bartoszp1992/airMouse/housing/RC1_main.FCStd

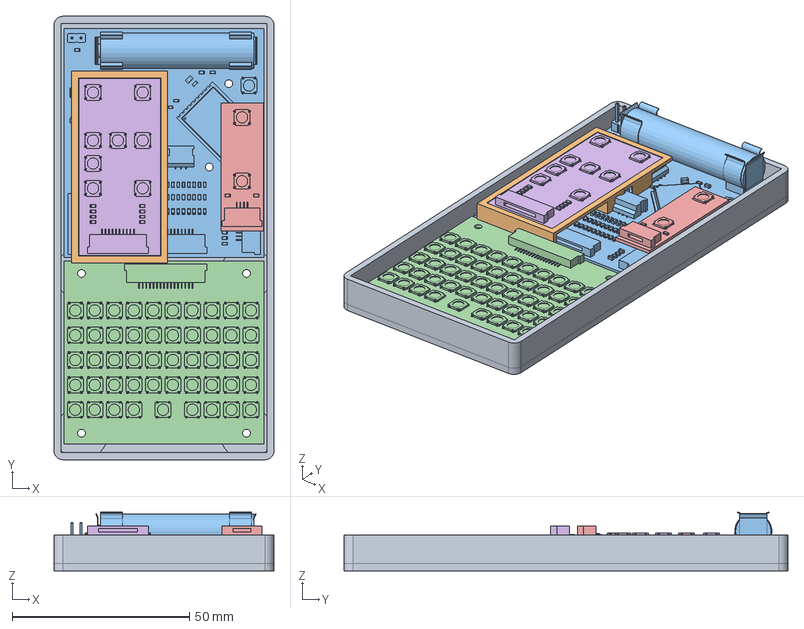
[picture p2: CAD file, 2025-02-20]
housing/RC1_main.FCStd
62.0 x 125.0 x 16.5 mm
housing
mouse distance
airMouse-mcu
airMouse-keyboard
airMouse-thumb
airMouse-mouse
