bartoszp1992/airMouse/housing/mini2/output/mini2-main.stl

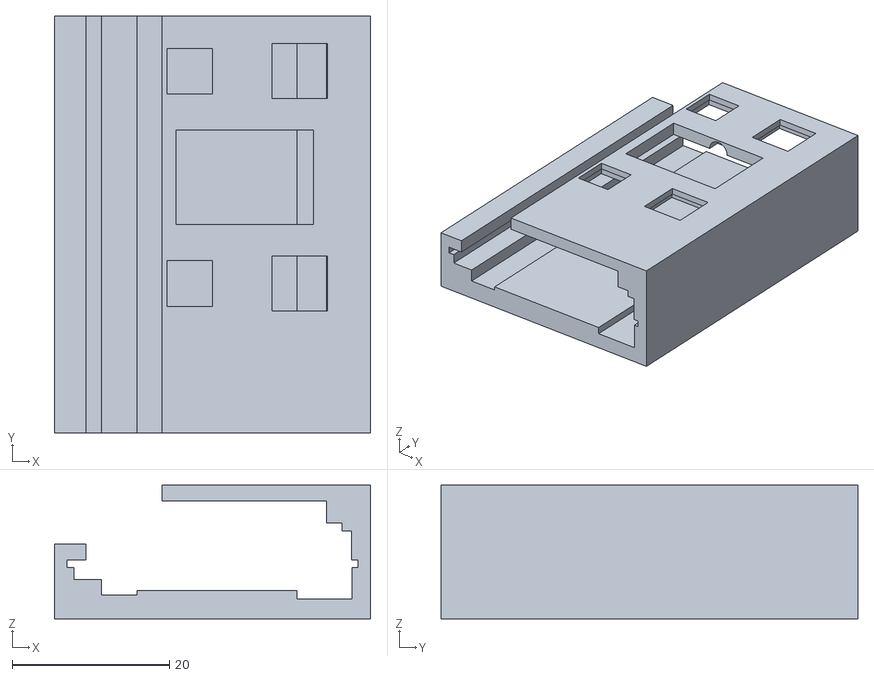
[picture p3: CAD file, 2025-04-11]
housing/mini2/output/mini2-main.stl
40.2 x 53.0 x 17.0
