bartoszp1992/airMouse/housing/RC1/output/proto/RC1_main-bottom cover.stl

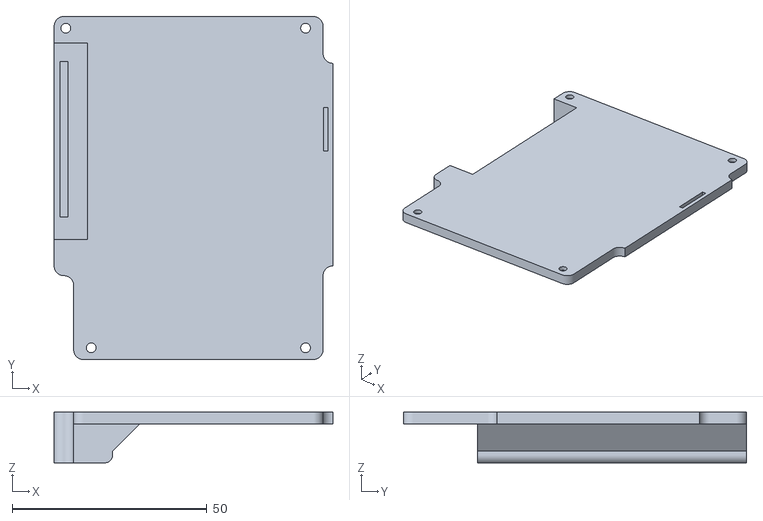
[picture p4: CAD file, 2025-03-11]
housing/RC1/output/proto/RC1_main-bottom cover.stl
71.5 x 88.0 x 13.0
