bartoszp1992/airMouse/housing/RC1/output/proto/RC1_main-top base.stl

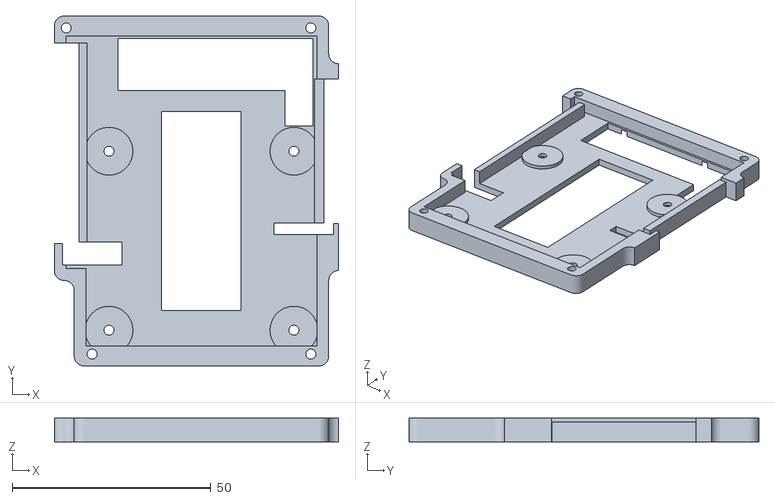
[picture p5: CAD file, 2025-03-11]
housing/RC1/output/proto/RC1_main-top base.stl
71.5 x 88.0 x 6.00
