bartoszp1992/airMouse/housing/RC1/output/proto/RC1_main-top cover.stl

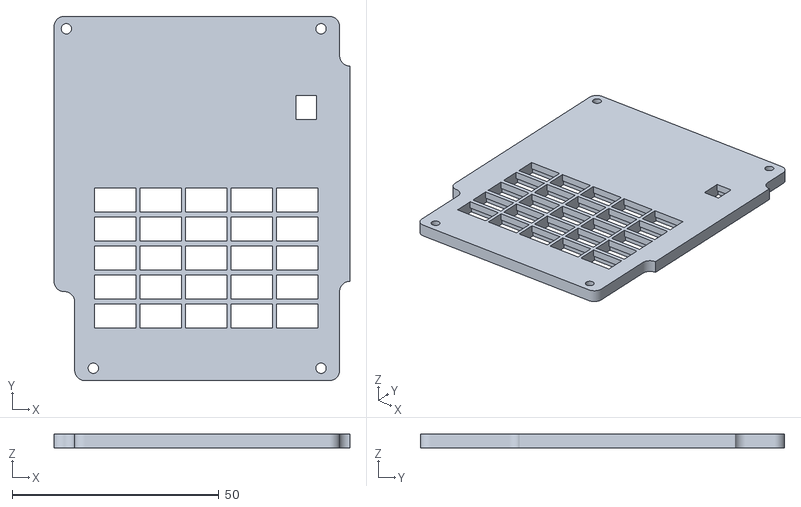
[picture p6: CAD file, 2025-03-11]
housing/RC1/output/proto/RC1_main-top cover.stl
71.5 x 88.0 x 3.50
