bartoszp1992/airMouse/housing/RC1/output/proto/RC1_main-integrating pin.stl

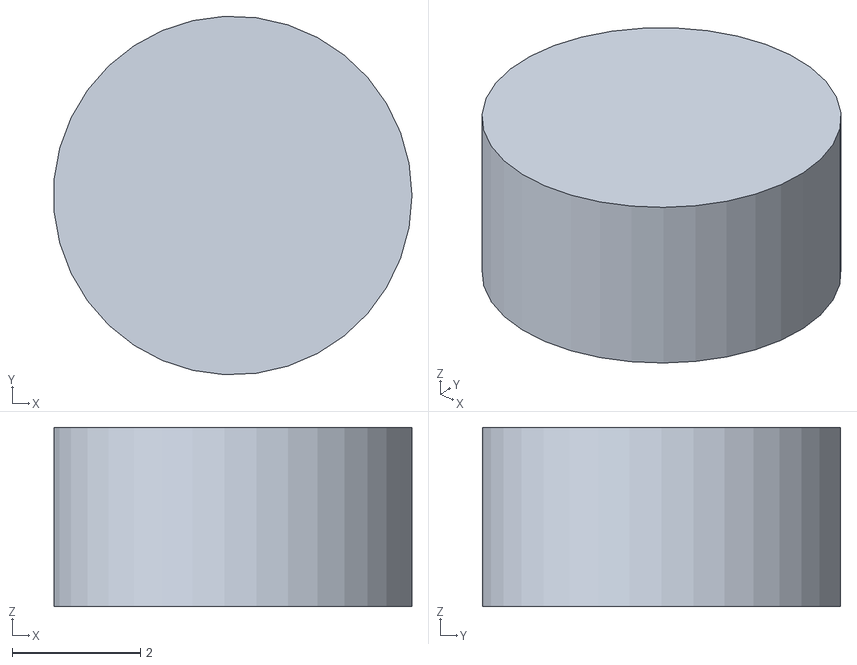
[picture p7: CAD file, 2025-03-11]
housing/RC1/output/proto/RC1_main-integrating pin.stl
5.59 x 5.59 x 2.80
