bartoszp1992/airMouse/housing/RC1/output/proto/RC1_main-laser key.stl

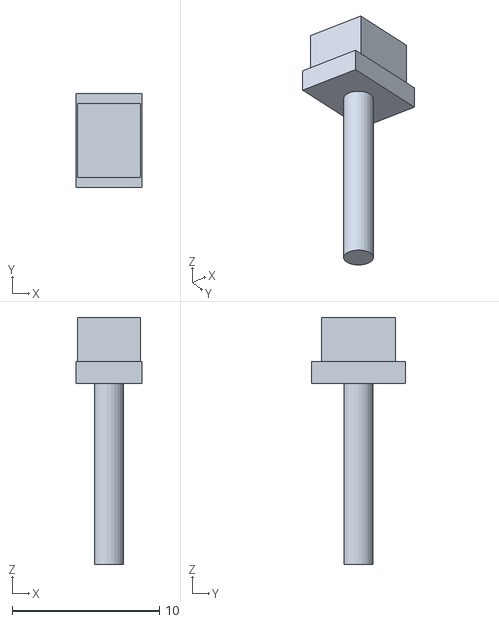
[picture p8: CAD file, 2025-02-27]
housing/RC1/output/proto/RC1_main-laser key.stl
4.50 x 6.40 x 16.8
