bartoszp1992/airMouse/housing/RC1/output/proto/RC1_main-keyboard array.stl

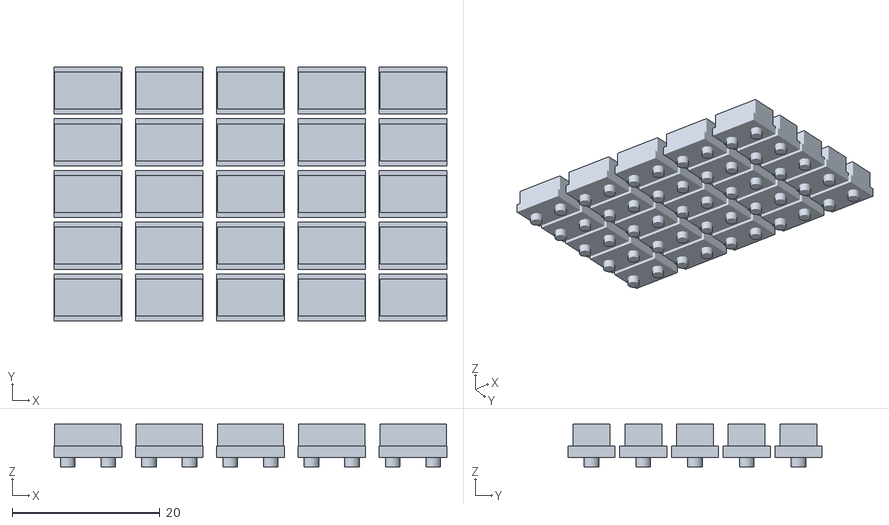
[picture p9: CAD file, 2025-02-27]
housing/RC1/output/proto/RC1_main-keyboard array.stl
53.2 x 34.4 x 5.80
