bartoszp1992/airMouse/housing/mini/output/mini-Body.stl

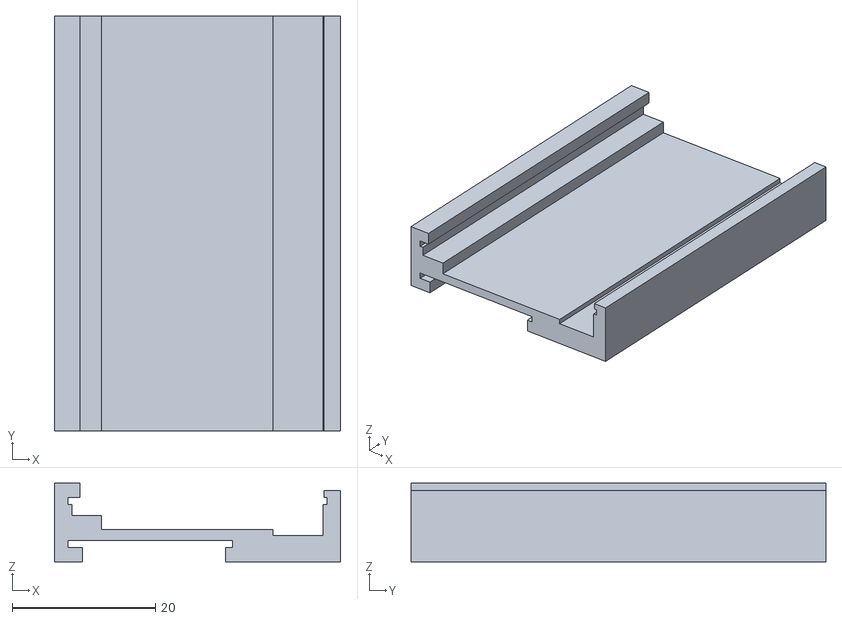
[picture p10: CAD file, 2025-03-31]
housing/mini/output/mini-Body.stl
40.0 x 58.0 x 11.0
