bartoszp1992/airMouse/housing/mini2/output/mini2-scroll.stl

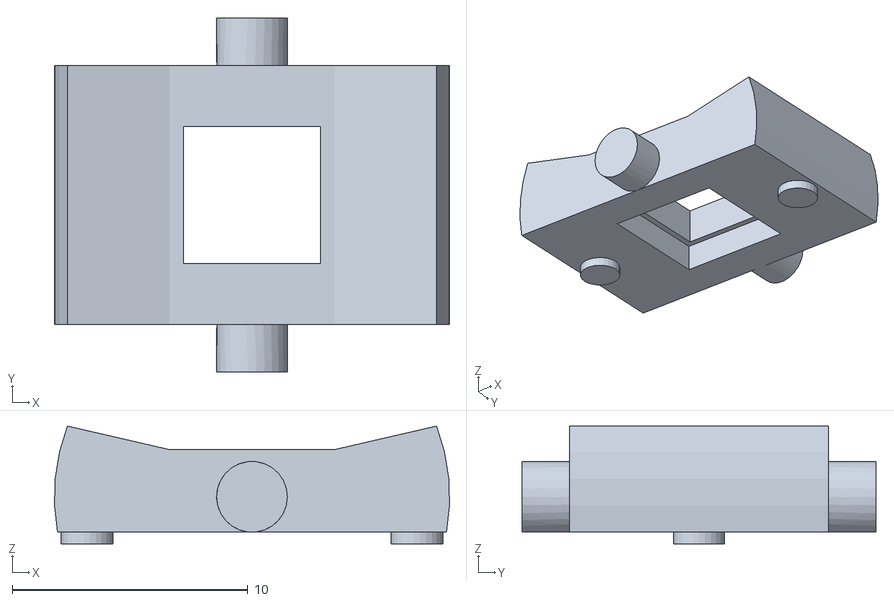
[picture p11: CAD file, 2025-04-11]
housing/mini2/output/mini2-scroll.stl
16.8 x 15.0 x 5.00
