bartoszp1992/airMouse/housing/pcb_model/airMouse-thumb.step

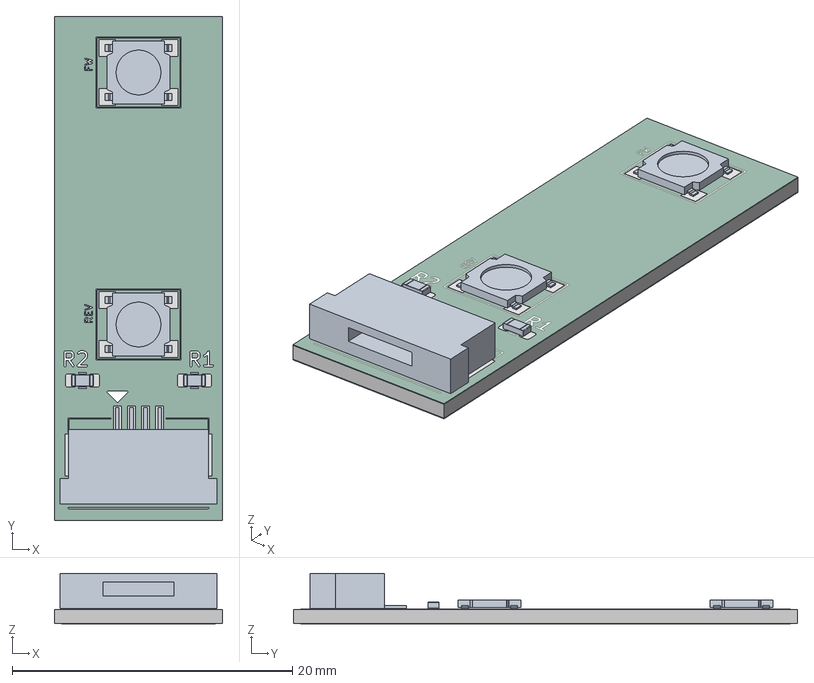
[picture p12: CAD file, 2025-02-21]
housing/pcb_model/airMouse-thumb.step
12.0 x 36.0 x 3.66 mm
R_0603_1608Metric x 2
TL3315NF100Q x 2
DS1020-07-4VBT1A-R
airMouse-thumb_copper
airMouse-thumb_pad
airMouse-thumb_via
airMouse-thumb_silkscreen
airMouse-thumb_soldermask
airMouse-thumb_PCB
