bartoszp1992/airMouse/housing/pcb_model/airMouse-keyboard.step

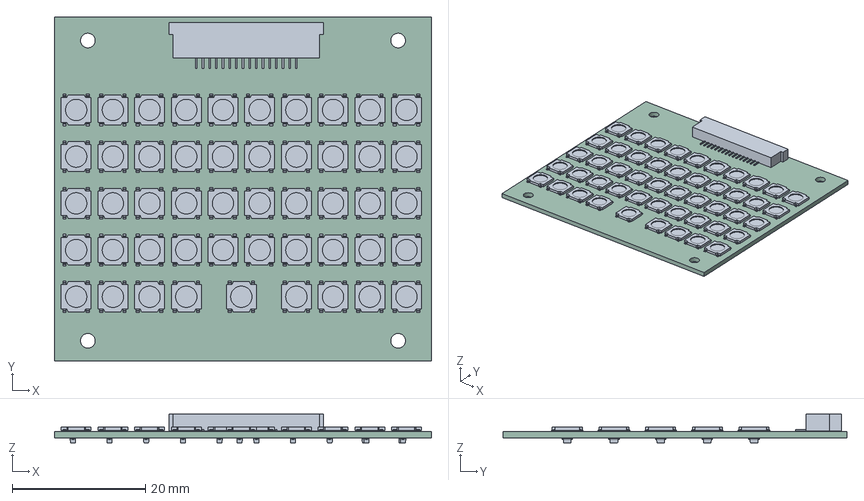
[picture p13: CAD file, 2025-02-20]
housing/pcb_model/airMouse-keyboard.step
56.5 x 51.5 x 4.30 mm
TL3315NF100Q x 49
DS1020-07-16VBT1A-R
D_SOD-523 x 49
airMouse-keyboard_PCB
