bartoszp1992/airMouse/housing/mini2/output/mini2-lid.stl

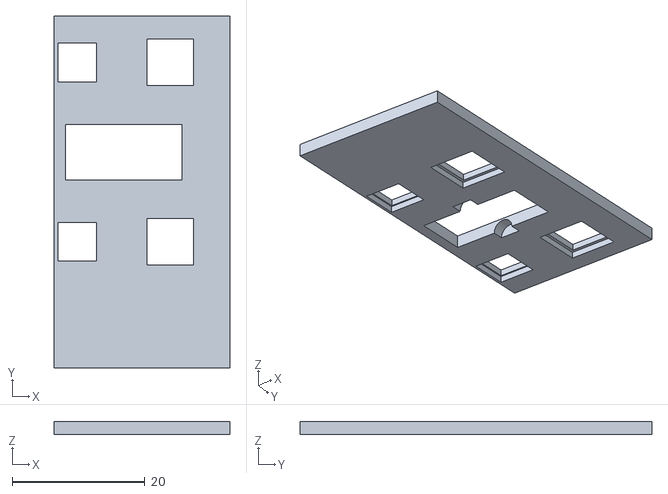
[picture p14: CAD file, 2025-04-02]
housing/mini2/output/mini2-lid.stl
26.5 x 53.0 x 2.00
