bartoszp1992/airMouse/housing/pcb_model/airMouse-mcu.step

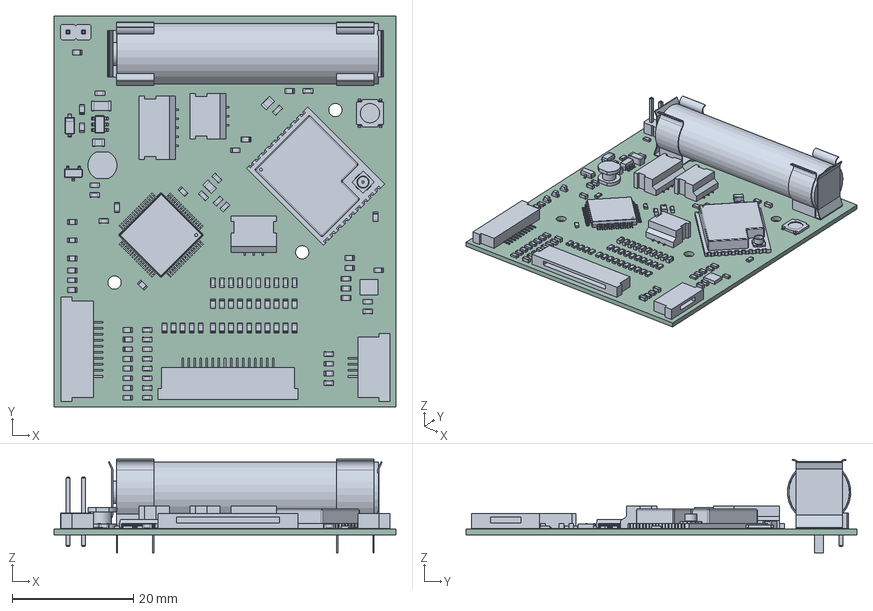
[picture p15: CAD file, 2025-02-20]
housing/pcb_model/airMouse-mcu.step
56.5 x 64.5 x 15.4 mm
C_0603_1608Metric x 32
R_0603_1608Metric x 54
TL3315NF100Q
DLG-0403-4R7
AAA
BC-0401 x 2
ESP32-C3-WROOM-02U
ZH-S3B-SM4A x 2
DS1020-07-10VBT1A-R
DS1020-07-16VBT1A-R
C_0805_2012Metric x 3
LED_0603_1608Metric x 3
SOT-23
C_1206_3216Metric
D_SOD-123
DS1020-07-4VBT1A-R
SOT-23-6
PinHeader_1x02_P2.54mm_Vertical
LQFP-64_10x10mm_P0.5mm
LGA-14_3x2.5mm_P0.5mm_LayoutBorder3x4y
ZH-S5B-SM4A
airMouse-mcu_PCB
