bartoszp1992/airMouse/housing/mini2/output/mini2-button small.stl

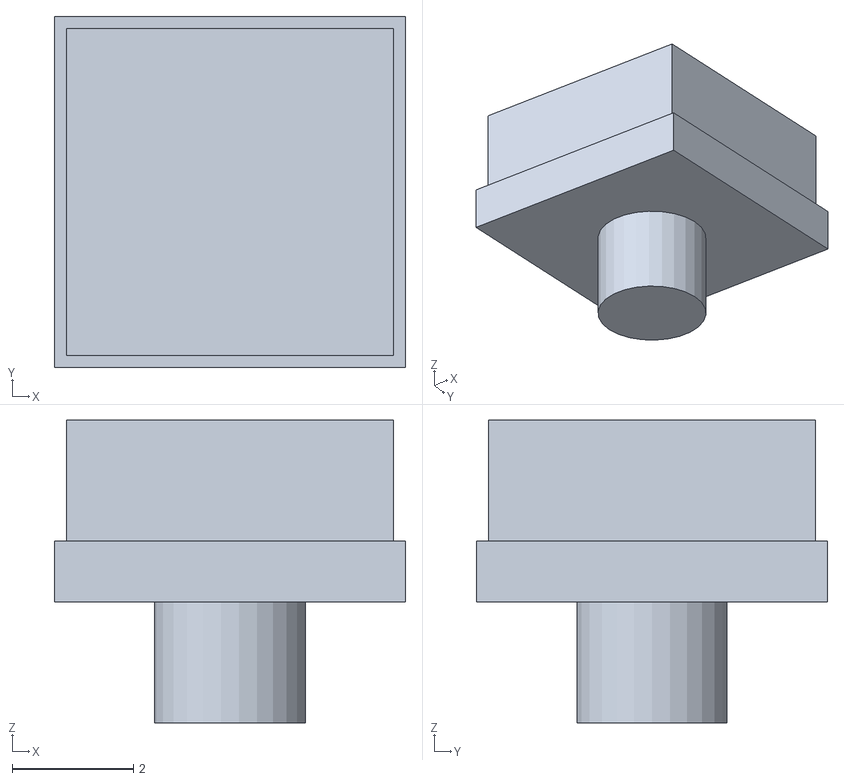
[picture p16: CAD file, 2025-04-02]
housing/mini2/output/mini2-button small.stl
5.80 x 5.80 x 5.00
