bartoszp1992/airMouse/housing/pcb_model/airMouse-mouse.step

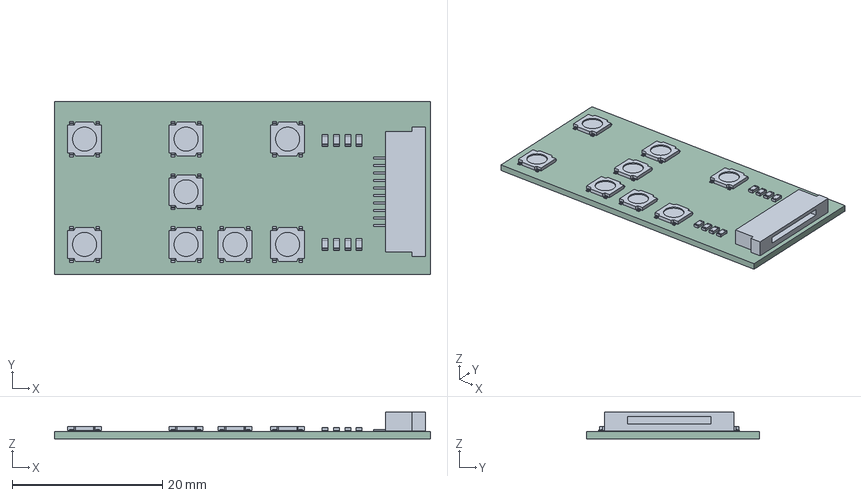
[picture p17: CAD file, 2025-02-20]
housing/pcb_model/airMouse-mouse.step
50.0 x 23.0 x 3.58 mm
R_0603_1608Metric x 8
TL3315NF100Q x 8
DS1020-07-10VBT1A-R
airMouse-mouse_PCB
