bartoszp1992/airMouse/housing/mini2/output/mini2-button middle.stl

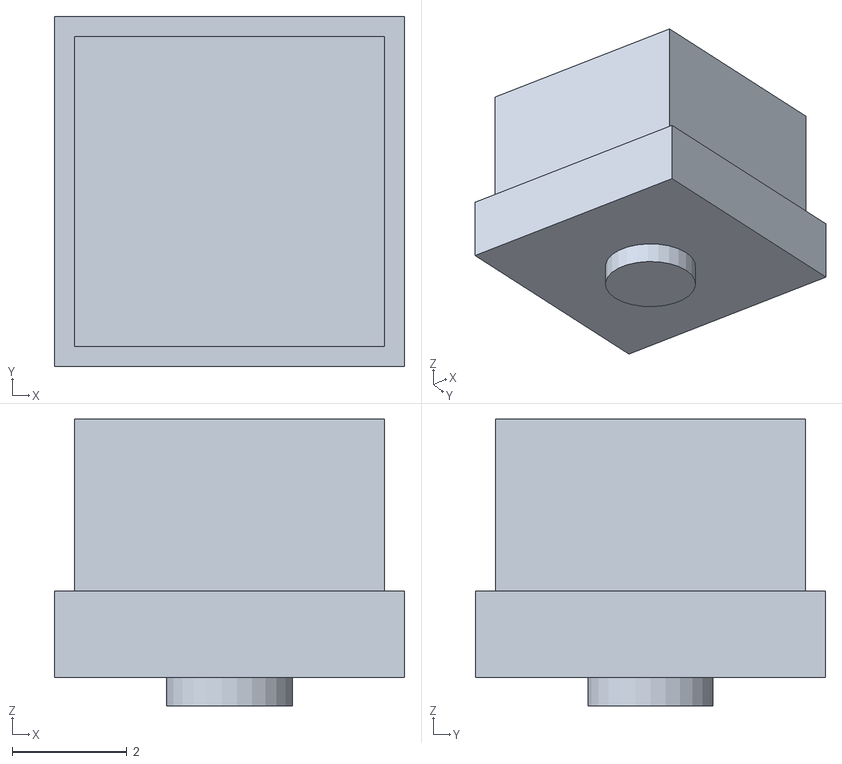
[picture p18: CAD file, 2025-04-02]
housing/mini2/output/mini2-button middle.stl
6.10 x 6.10 x 5.00
