bartoszp1992/airMouse/housing/mini2/output/mini2-button large.stl

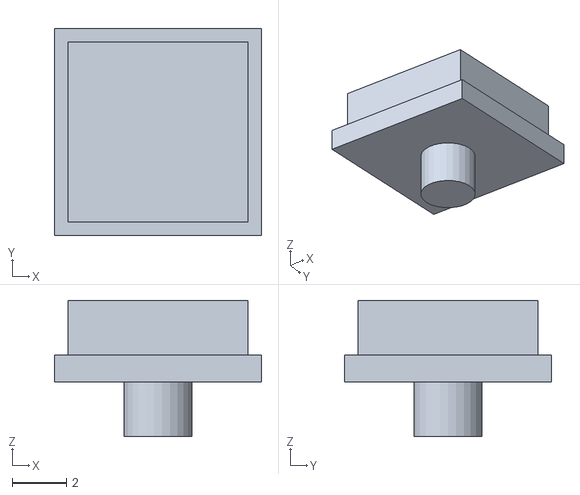
[picture p19: CAD file, 2025-04-02]
housing/mini2/output/mini2-button large.stl
7.60 x 7.60 x 5.00
