bartoszp1992/airMouse/housing/mini2/output/mini2-distance.stl

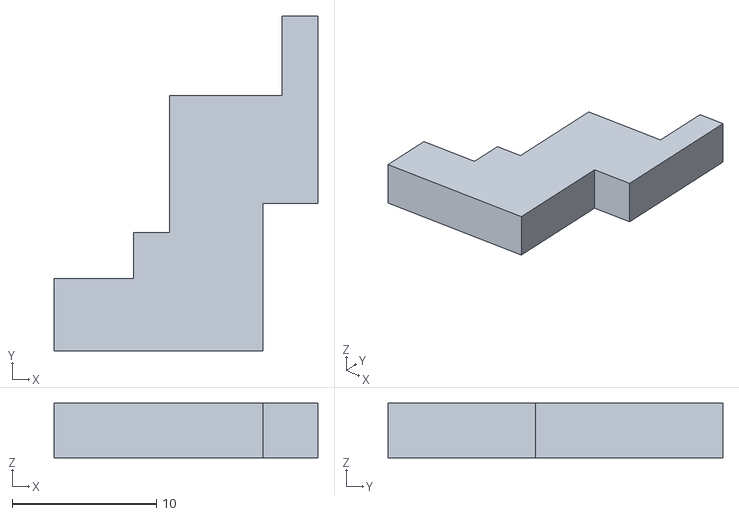
[picture p20: CAD file, 2025-03-31]
housing/mini2/output/mini2-distance.stl
18.3 x 23.2 x 3.80
