bartoszp1992/airMouse/(list of files, cad)

Other CAD files:
housing/RC1/RC1_assembly.FCStd
housing/pcb_model/airMouse-mouse.stl
housing/pcb_model/airMouse-thumb.stl
