bartoszp1992/airMouse/hardware/airMouse-mouse/airMouse-mouse.kicad_pcb

## KiCad design hardware/airMouse-mouse/airMouse-mouse.kicad_pcb (2025-04-01)

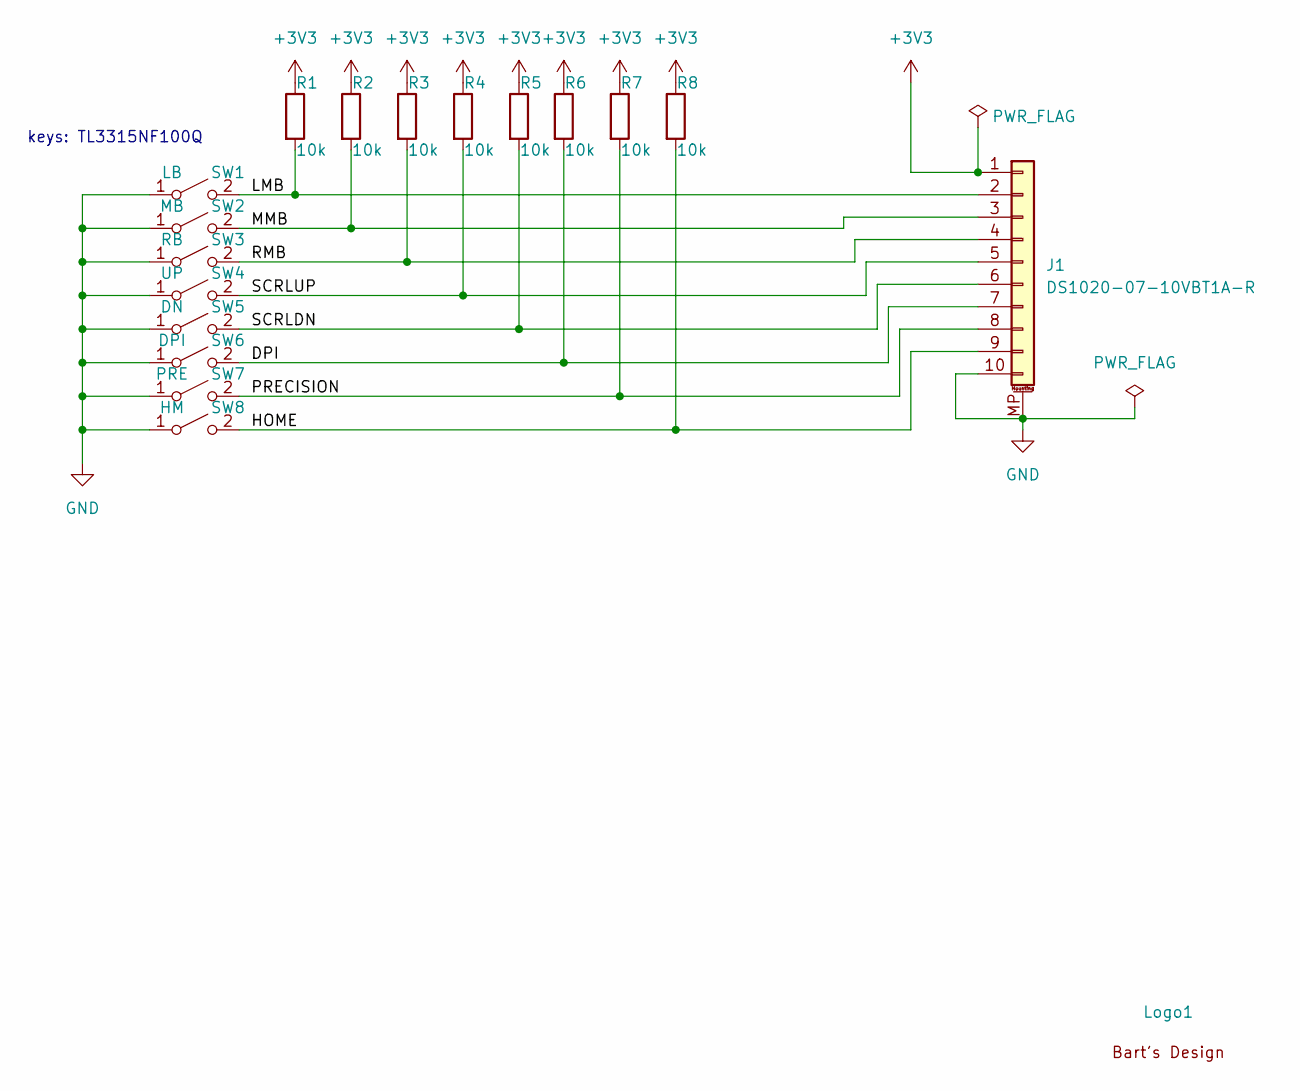
[picture p24: schematic airMouse-mouse.kicad_sch, EtherPointer mouse]

Parts:
J1: DS1020-07-10VBT1A-R
Logo1: Bart's Design 30mm
R1, R2, R3, R4, R5, R6, R7, R8: 10k; R_0603_1608Metric
SW1, SW2, SW3, SW4, SW5, SW6, SW7, SW8: KEY; TL3315NF100Q

Connections:
+3V3: J1.1, R1.1, R2.1, R3.1, R4.1, R5.1, R6.1, R7.1, R8.1
/DPI: J1.7, R6.2, SW6.2 (B)
/HOME: J1.9, R8.2, SW8.2 (B)
/LMB: J1.2, R1.2, SW1.2 (B)
/MMB: J1.3, R2.2, SW2.2 (B)
/PRECISION: J1.8, R7.2, SW7.2 (B)
/RMB: J1.4, R3.2, SW3.2 (B)
/SCRLDN: J1.6, R5.2, SW5.2 (B)
/SCRLUP: J1.5, R4.2, SW4.2 (B)
GND: J1.10, J1.MP (MountPin), SW1.1 (A), SW2.1 (A), SW3.1 (A), SW4.1 (A), SW5.1 (A), SW6.1 (A), SW7.1 (A), SW8.1 (A)

Notes on the sheet:
keys: TL3315NF100Q

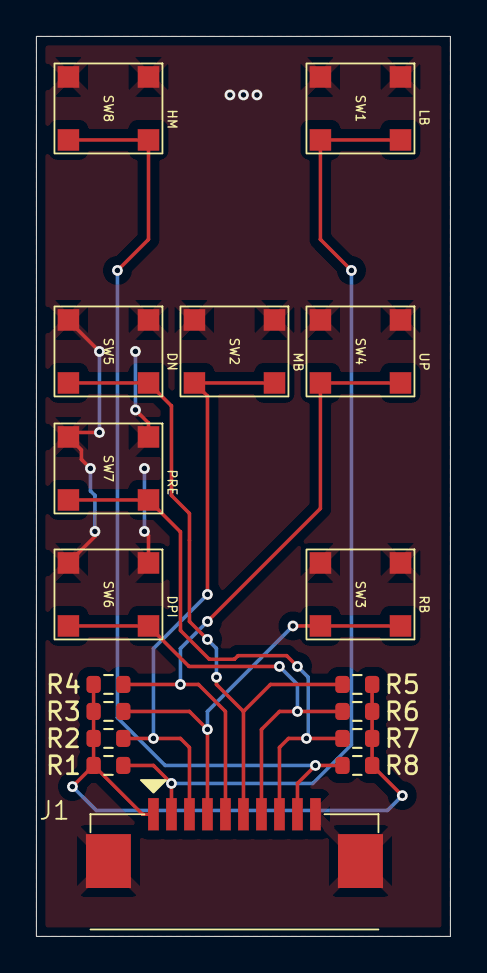
[picture p25: board airMouse-mouse.kicad_pcb from above]

Board: 2 copper layers, 23.0 x 50.0 mm, 18 parts (1 on the bottom side), 10 nets.
