bartoszp1992/airMouse/hardware/airMouse-mcu/airMouse-mcu.kicad_pcb

## KiCad design hardware/airMouse-mcu/airMouse-mcu.kicad_pcb (2025-03-31)

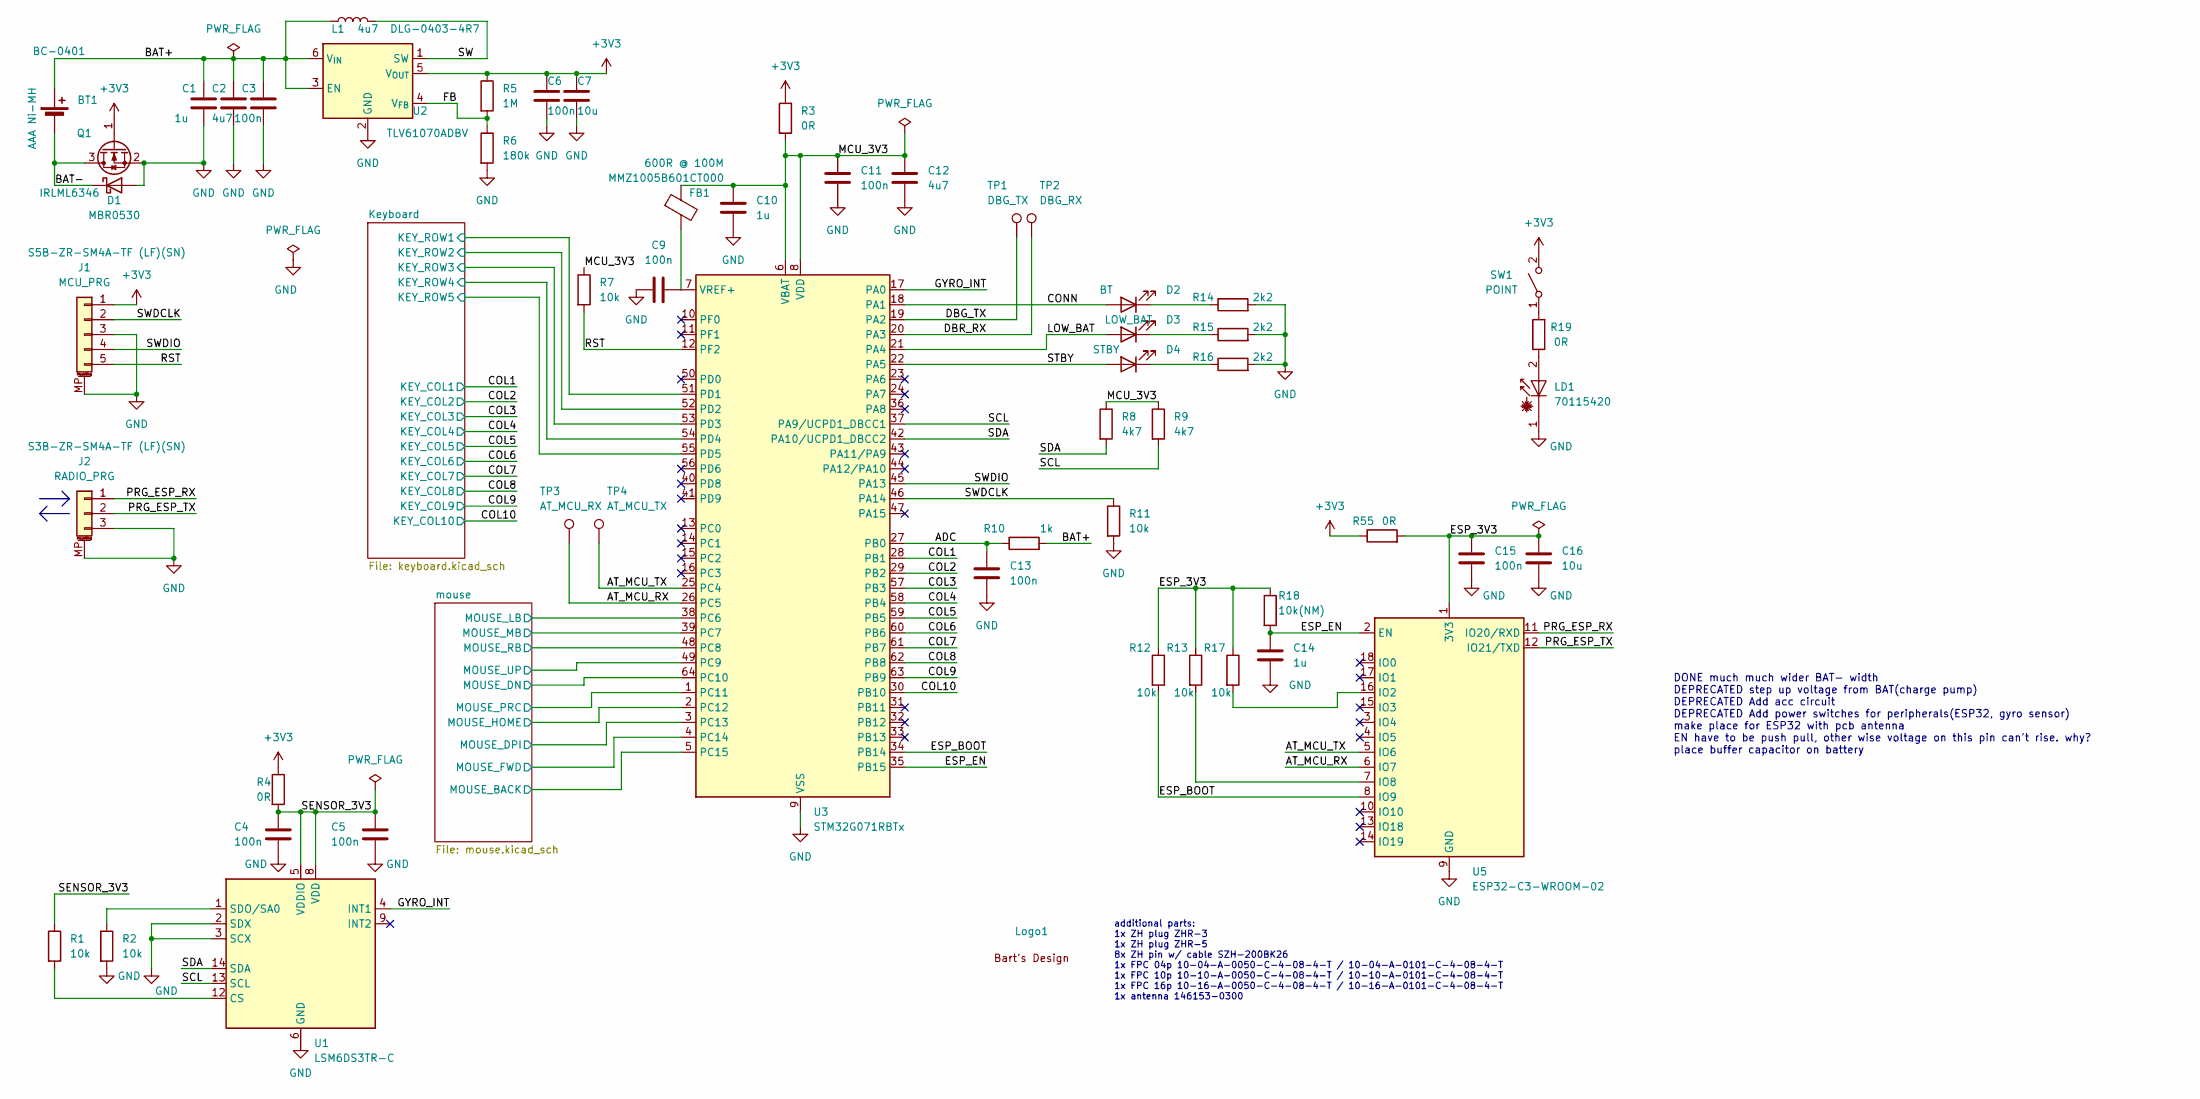
[picture p26: schematic airMouse-mcu.kicad_sch, Neuro Glider]

Parts:
BT1: BC-0401
C1, C10, C14: 1u; C_0603_1608Metric
C2, C12: 4u7; C_0805_2012Metric
C3, C4, C5, C6, C9, C11, C13, C15: 100n; C_0603_1608Metric
C7, C16: 10u; C_0805_2012Metric
D1: MBR0530; D_SOD-123
D2: BT; LED_0603_1608Metric
D3: LOW_BAT; LED_0603_1608Metric
D4: STBY; LED_0603_1608Metric
FB1: 600R @ 100M; C_0603_1608Metric
J1: MCU_PRG; JST_ZH_S5B-ZR-SM4A-TF_1x05-1MP_P1.50mm_Horizontal
J2: RADIO_PRG; JST_ZH_S3B-ZR-SM4A-TF_1x03-1MP_P1.50mm_Horizontal
L1: 4u7; L_Ferrocore_DLG-0403
LD1: 70115420; PinHeader_1x02_P2.54mm_Vertical
Logo1: Bart's Design 30mm
Q1: IRLML6346; SOT-23
R1, R2, R7, R11, R12, R13, R17: 10k; R_0603_1608Metric
R3, R4, R19, R55: 0R; R_0603_1608Metric
R5: 1M; R_0603_1608Metric
R6: 180k; R_0603_1608Metric
R8, R9: 4k7; R_0603_1608Metric
R10: 1k; R_0603_1608Metric
R14, R15, R16: 2k2; R_0603_1608Metric
R18: 10k(NM); R_0603_1608Metric
SW1: KEY; TL3315NF100Q
TP1: DBG_TX; TestPoint_Pad_D1.0mm
TP2: DBG_RX; TestPoint_Pad_D1.0mm
TP3: AT_MCU_RX; TestPoint_Pad_D1.0mm
TP4: AT_MCU_TX; TestPoint_Pad_D1.0mm
U1: LSM6DS3TR-C; LGA-14_3x2.5mm_P0.5mm_LayoutBorder3x4y
U2: TLV61070ADBV; SOT-23-6
U3: STM32G071RBTx; LQFP-64_10x10mm_P0.5mm
U5: ESP32-C3-WROOM-02

Connections:
+3V3: C6.1, C7.1, J1.1, Q1.1 (G), R3.1, R4.1, R5.1, R55.1, SW1.2 (B), U2.5 (V_{OUT}); also elsewhere on the board
/ADC: C13.1, R10.1, U3.27 (PB0)
/AT_MCU_RX: TP3.1, U3.26 (PC5), U5.6 (IO7)
/AT_MCU_TX: TP4.1, U3.25 (PC4), U5.5 (IO6)
/BAT+: BT1.1 (+), C1.1, C2.1, C3.1, L1.1, R10.2, U2.3 (EN), U2.6 (V_{IN})
/BAT-: BT1.2 (-), D1.1 (K), Q1.3 (D)
/COL1: U3.28 (PB1); also elsewhere on the board
/COL2: U3.29 (PB2); also elsewhere on the board
/COL3: U3.57 (PB3); also elsewhere on the board
/COL4: U3.58 (PB4); also elsewhere on the board
/COL5: U3.59 (PB5); also elsewhere on the board
/COL6: U3.60 (PB6); also elsewhere on the board
/COL7: U3.61 (PB7); also elsewhere on the board
/COL8: U3.62 (PB8); also elsewhere on the board
/COL9: U3.63 (PB9); also elsewhere on the board
/COL10: U3.30 (PB10); also elsewhere on the board
/CONN: D2.2 (A), U3.18 (PA1)
/DBG_TX: TP1.1, U3.19 (PA2)
/DBR_RX: TP2.1, U3.20 (PA3)
/ESP_3V3: C15.1, C16.1, R12.1, R13.1, R17.1, R18.1, R55.2, U5.1 (3V3)
/ESP_BOOT: R12.2, U3.34 (PB14), U5.8 (IO9)
/ESP_EN: C14.1, R18.2, U3.35 (PB15), U5.2 (EN)
/FB: R5.2, R6.1, U2.4 (V_{FB})
/GYRO_INT: U1.4 (INT1), U3.17 (PA0)
/Keyboard/KEY_ROW1: U3.51 (PD1); also elsewhere on the board
/Keyboard/KEY_ROW2: U3.52 (PD2); also elsewhere on the board
/Keyboard/KEY_ROW3: U3.53 (PD3); also elsewhere on the board
/Keyboard/KEY_ROW4: U3.54 (PD4); also elsewhere on the board
/Keyboard/KEY_ROW5: U3.55 (PD5); also elsewhere on the board
/LOW_BAT: D3.2 (A), U3.21 (PA4)
/MCU_3V3: C10.1, C11.1, C12.1, FB1.1, R3.2, R7.1, R8.1, R9.1, U3.6 (VBAT), U3.8 (VDD)
/PRG_ESP_RX: J2.1, U5.11 (IO20/RXD)
/PRG_ESP_TX: J2.2, U5.12 (IO21/TXD)
/RST: J1.5, R7.2, U3.12 (PF2)
/SCL: R9.2, U1.13 (SCL), U3.37 (PA9/UCPD1_DBCC1)
/SDA: R8.2, U1.14 (SDA), U3.42 (PA10/UCPD1_DBCC2)
/SENSOR_3V3: C4.1, C5.1, R1.1, R4.2, U1.5 (VDDIO), U1.8 (VDD)
/STBY: D4.2 (A), U3.22 (PA5)
/SW: L1.2, U2.1 (SW)
/SWDCLK: J1.2, R11.1, U3.46 (PA14)
/SWDIO: J1.4, U3.45 (PA13)
/mouse/MOUSE_BACK: U3.5 (PC15); also elsewhere on the board
/mouse/MOUSE_DN: U3.64 (PC10); also elsewhere on the board
/mouse/MOUSE_DPI: U3.3 (PC13); also elsewhere on the board
/mouse/MOUSE_FWD: U3.4 (PC14); also elsewhere on the board
/mouse/MOUSE_HOME: U3.2 (PC12); also elsewhere on the board
/mouse/MOUSE_LB: U3.38 (PC6); also elsewhere on the board
/mouse/MOUSE_MB: U3.39 (PC7); also elsewhere on the board
/mouse/MOUSE_PRC: U3.1 (PC11); also elsewhere on the board
/mouse/MOUSE_RB: U3.48 (PC8); also elsewhere on the board
/mouse/MOUSE_UP: U3.49 (PC9); also elsewhere on the board
GND: C1.2, C2.2, C3.2, C4.2, C5.2, C6.2, C7.2, C9.2, C10.2, C11.2, C12.2, C13.2, C14.2, C15.2, C16.2, D1.2 (A), J1.3, J1.MP (MountPin), J2.3, J2.MP (MountPin), LD1.1 (K), Q1.2 (S), R2.2, R6.2, R11.2, R14.2, R15.2, R16.2, U1.2 (SDX), U1.3 (SCX), U1.6 (GND), U1.7 (GND), U2.2 (GND), U3.9 (VSS), U5.9 (GND), U5.19 (GND); also elsewhere on the board
unnamed: D2.1 (K), R14.1
unnamed: D3.1 (K), R15.1
unnamed: D4.1 (K), R16.1
unnamed: LD1.2 (A), R19.1
unnamed: R19.2, SW1.1 (A)
unnamed: R1.2, U1.12 (CS)
unnamed: R2.1, U1.1 (SDO/SA0)
unnamed: C9.1, FB1.2, U3.7 (VREF+)
unnamed: R17.2, U5.16 (IO2)
unnamed: R13.2, U5.7 (IO8)

Notes on the sheet:
additional parts: 1x ZH plug ZHR-3 1x ZH plug ZHR-5 8x ZH pin w/ cable SZH-200BK26 1x FPC 04p 10-04-A-0050-C-4-08-4-T / 10-04-A-0101-C-4-08-4-T 1x FPC 10p 10-10-A-0050-C-4-08-4-T / 10-10-A-0101-C-4-08-4-T 1x FPC 16p 10-16-A-0050-C-4-08-4-T / 10-16-A-0101-C-4-08-4-T 1x antenna 146153-0300
DONE much much wider BAT- width DEPRECATED step up voltage from BAT(charge pump) DEPRECATED Add acc circuit DEPRECATED Add power switches for peripherals(ESP32, gyro sensor) make place for ESP32 with pcb antenna EN have to be push pull, other wise voltage on this pin can't rise. why? place buffer c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

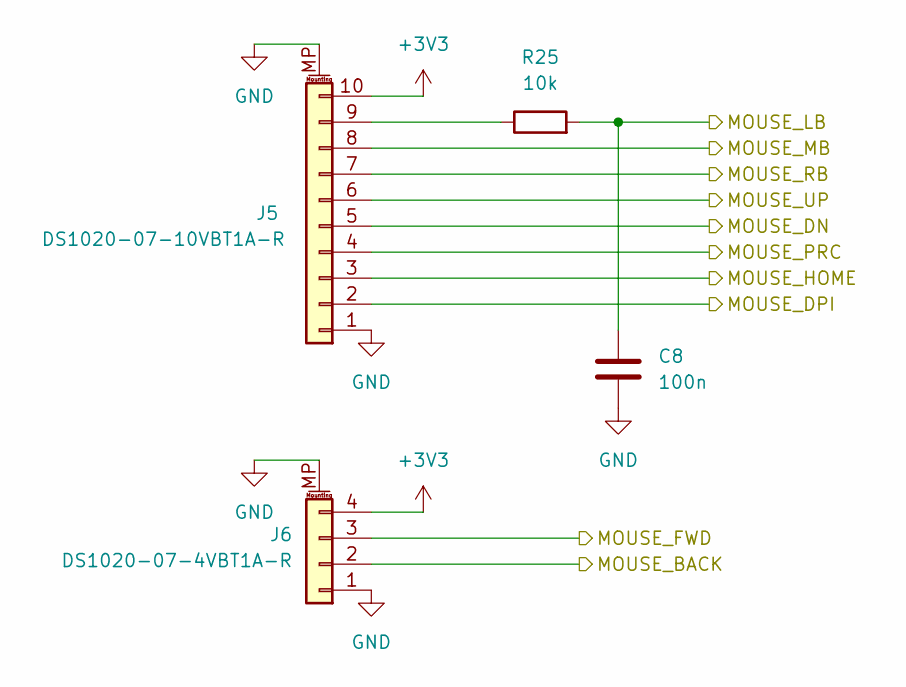
[picture p27: schematic mouse.kicad_sch, Neuro Glider]

Parts:
C8: 100n; C_0603_1608Metric
J5: DS1020-07-10VBT1A-R
J6: DS1020-07-4VBT1A-R
R25: 10k; R_0603_1608Metric

Connections:
+3V3: J5.10, J6.4; also elsewhere on the board
/mouse/MOUSE_BACK: J6.2; also elsewhere on the board
/mouse/MOUSE_DN: J5.5; also elsewhere on the board
/mouse/MOUSE_DPI: J5.2; also elsewhere on the board
/mouse/MOUSE_FWD: J6.3; also elsewhere on the board
/mouse/MOUSE_HOME: J5.3; also elsewhere on the board
/mouse/MOUSE_LB: C8.1, R25.2; also elsewhere on the board
/mouse/MOUSE_MB: J5.8; also elsewhere on the board
/mouse/MOUSE_PRC: J5.4; also elsewhere on the board
/mouse/MOUSE_RB: J5.7; also elsewhere on the board
/mouse/MOUSE_UP: J5.6; also elsewhere on the board
GND: C8.2, J5.1, J5.MP (MountPin), J6.1, J6.MP (MountPin); also elsewhere on the board
unnamed: J5.9, R25.1

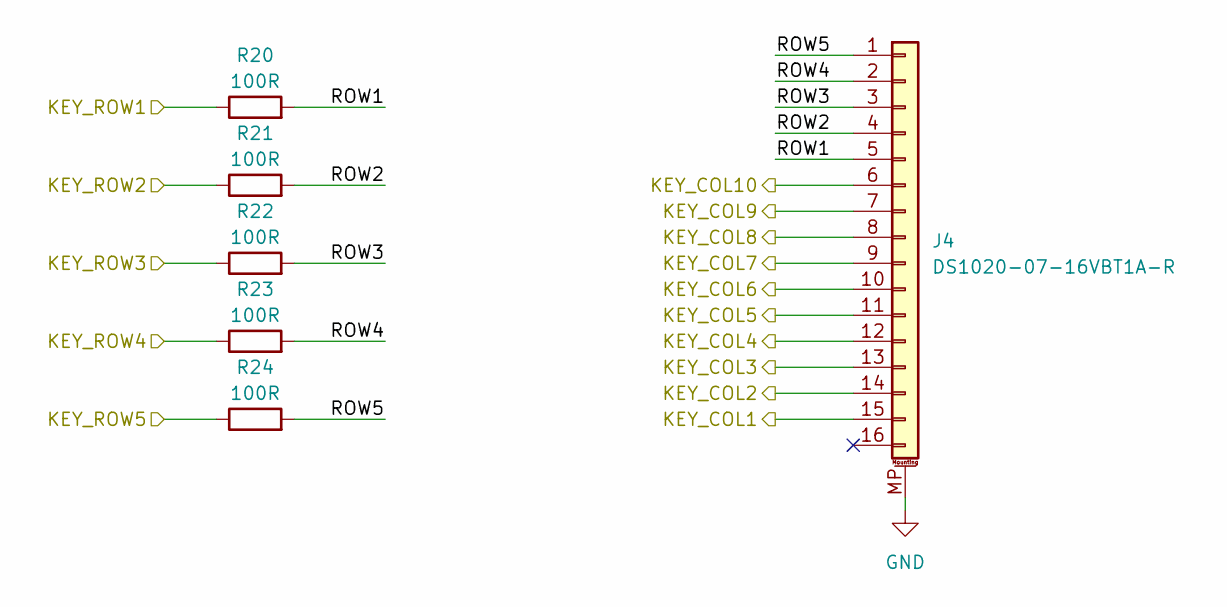
[picture p28: schematic keyboard.kicad_sch, Neuro Glider]

Parts:
J4: DS1020-07-16VBT1A-R
R20, R21, R22, R23, R24: 100R; R_0603_1608Metric

Connections:
/COL1: J4.15; also elsewhere on the board
/COL2: J4.14; also elsewhere on the board
/COL3: J4.13; also elsewhere on the board
/COL4: J4.12; also elsewhere on the board
/COL5: J4.11; also elsewhere on the board
/COL6: J4.10; also elsewhere on the board
/COL7: J4.9; also elsewhere on the board
/COL8: J4.8; also elsewhere on the board
/COL9: J4.7; also elsewhere on the board
/COL10: J4.6; also elsewhere on the board
/Keyboard/KEY_ROW1: R20.1; also elsewhere on the board
/Keyboard/KEY_ROW2: R21.1; also elsewhere on the board
/Keyboard/KEY_ROW3: R22.1; also elsewhere on the board
/Keyboard/KEY_ROW4: R23.1; also elsewhere on the board
/Keyboard/KEY_ROW5: R24.1; also elsewhere on the board
/Keyboard/ROW1: J4.5, R20.2
/Keyboard/ROW2: J4.4, R21.2
/Keyboard/ROW3: J4.3, R22.2
/Keyboard/ROW4: J4.2, R23.2
/Keyboard/ROW5: J4.1, R24.2
GND: J4.MP (MountPin); also elsewhere on the board

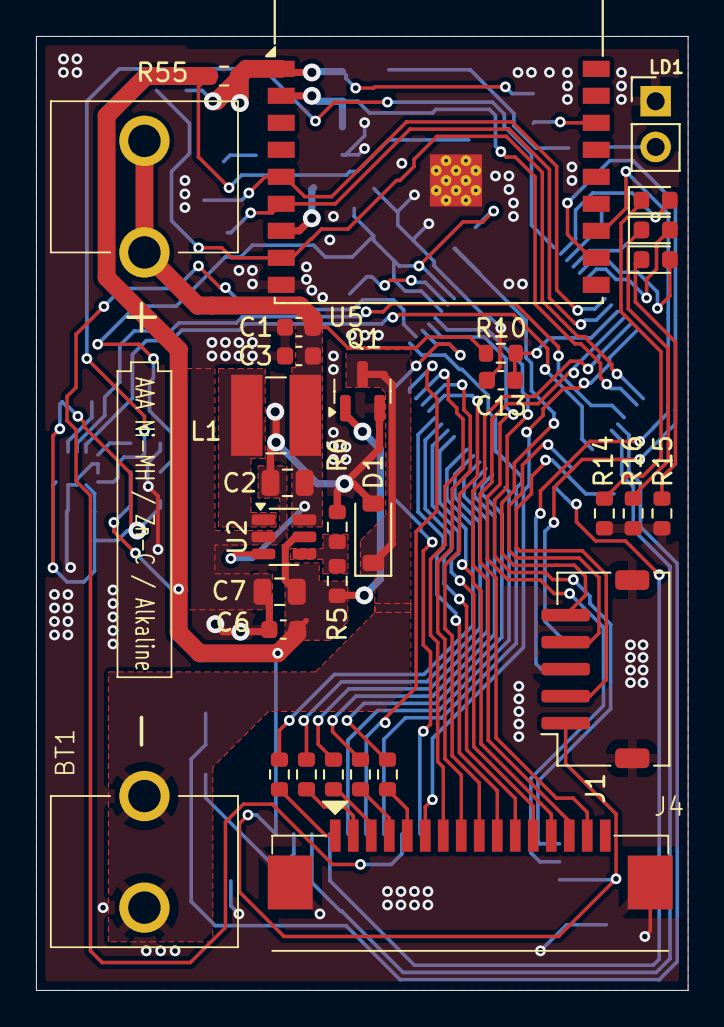
[picture p29: board airMouse-mcu.kicad_pcb from above]

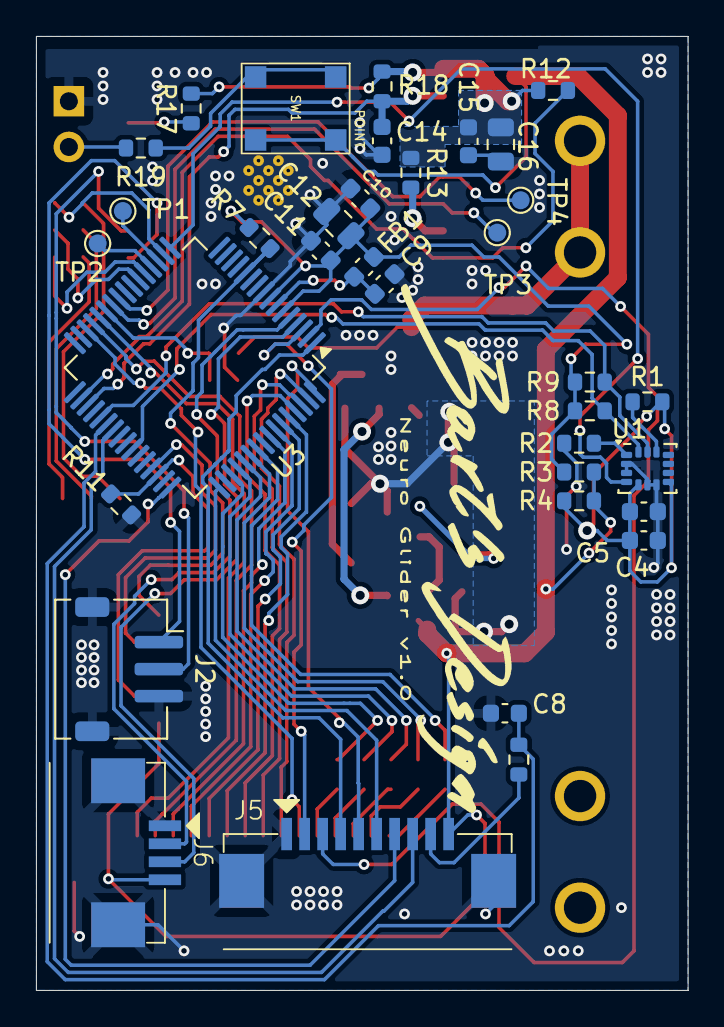
[picture p30: board airMouse-mcu.kicad_pcb from below]

Board: 2 copper layers, 36.2 x 53.0 mm, 66 parts (36 on the bottom side), 68 nets.
