bartoszp1992/airMouse/hardware/airMouse-keyboard/airMouse-keyboard.kicad_pcb

## KiCad design hardware/airMouse-keyboard/airMouse-keyboard.kicad_pcb (2025-02-27)

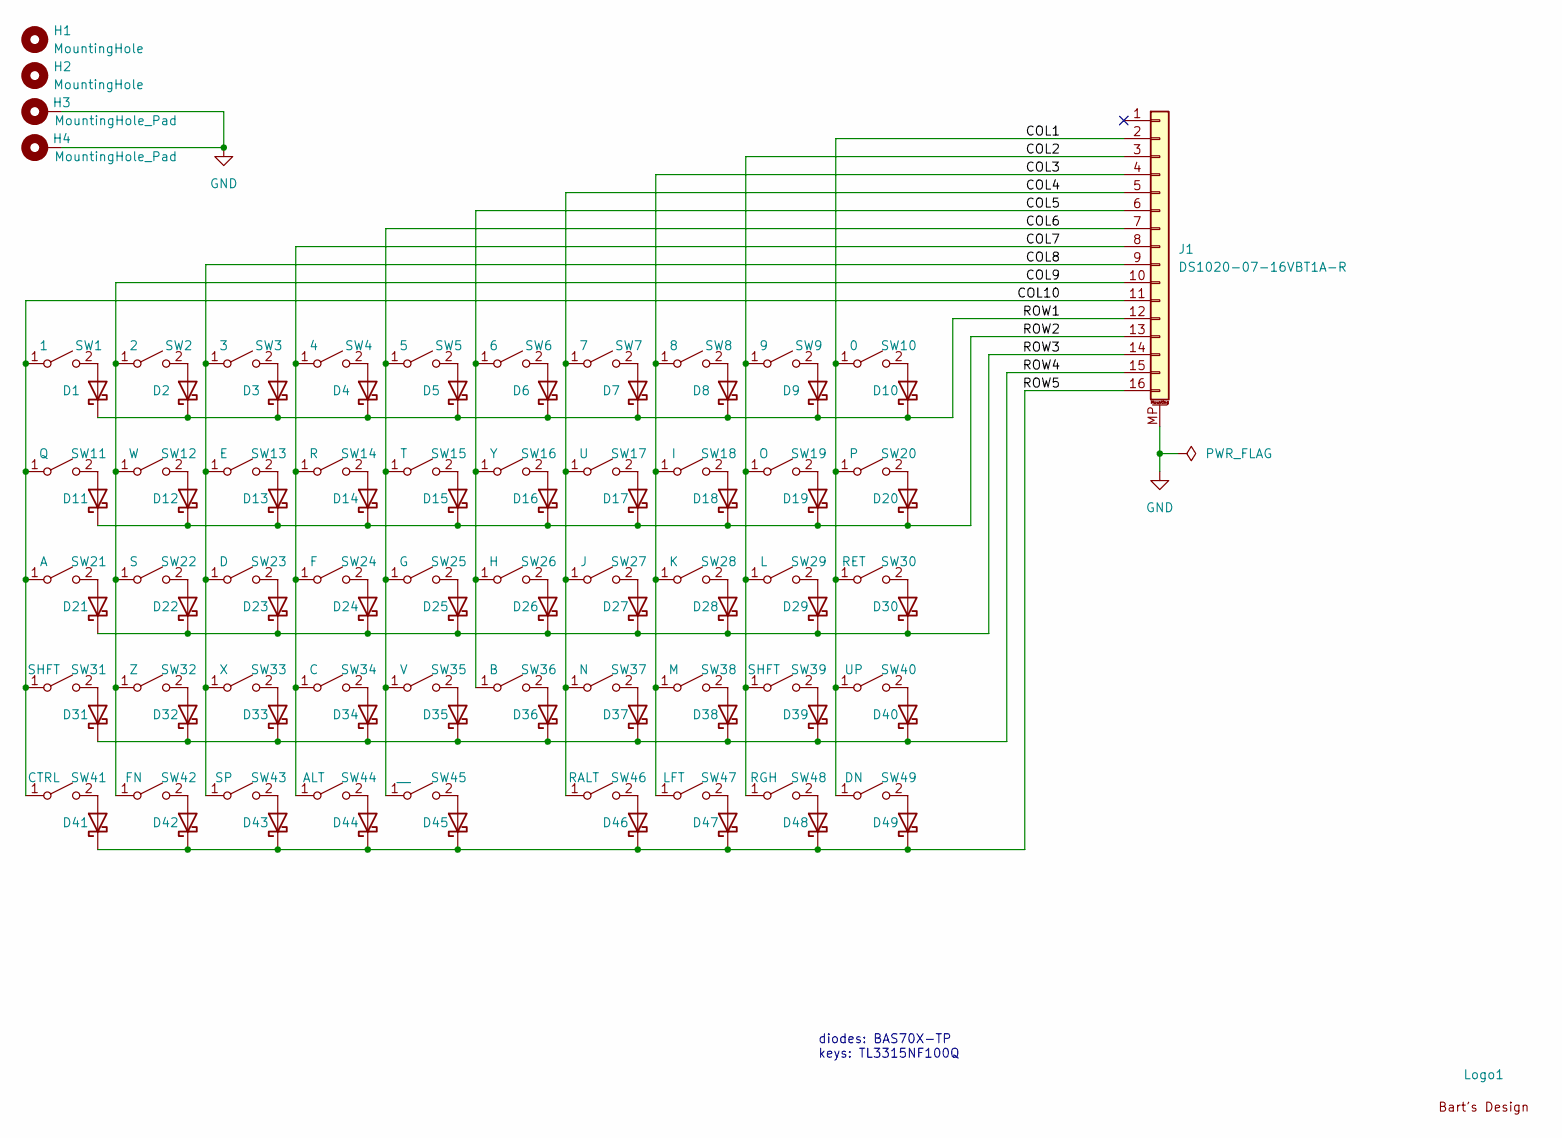
[picture p31: schematic airMouse-keyboard.kicad_sch, EtherPointer keyboard]

Parts:
D1, D2, D3, D4, D5, D6, D7, D8, D9, D10, D11, D12, D13, D14, D15, D16, D17, D18, D19, D20, D21, D22, D23, D24, D25, D26, D27, D28, D29, D30, D31, D32, D33, D34, D35, D36, D37, D38, D39, D40, D41, D42, D43, D44, D45, D46, D47, D48, D49: BAS70X-TP; D_SOD-523
H1, H2: MountingHole; MountingHole_2.2mm_M2_ISO14580
H3, H4: MountingHole_Pad; MountingHole_2.2mm_M2_ISO14580_Pad
J1: DS1020-07-16VBT1A-R
Logo1: Bart's Design 30mm
SW1, SW2, SW3, SW4, SW5, SW6, SW7, SW8, SW9, SW10, SW11, SW12, SW13, SW14, SW15, SW16, SW17, SW18, SW19, SW20, SW21, SW22, SW23, SW24, SW25, SW26, SW27, SW28, SW29, SW30, SW31, SW32, SW33, SW34, SW35, SW36, SW37, SW38, SW39, SW40, SW41, SW42, SW43, SW44, SW45, SW46, SW47, SW48, SW49: KEY; TL3315NF100Q

Connections:
/COL1: J1.2, SW10.1 (A), SW20.1 (A), SW30.1 (A), SW40.1 (A), SW49.1 (A)
/COL2: J1.3, SW9.1 (A), SW19.1 (A), SW29.1 (A), SW39.1 (A), SW48.1 (A)
/COL3: J1.4, SW8.1 (A), SW18.1 (A), SW28.1 (A), SW38.1 (A), SW47.1 (A)
/COL4: J1.5, SW7.1 (A), SW17.1 (A), SW27.1 (A), SW37.1 (A), SW46.1 (A)
/COL5: J1.6, SW6.1 (A), SW16.1 (A), SW26.1 (A), SW36.1 (A)
/COL6: J1.7, SW5.1 (A), SW15.1 (A), SW25.1 (A), SW35.1 (A), SW45.1 (A)
/COL7: J1.8, SW4.1 (A), SW14.1 (A), SW24.1 (A), SW34.1 (A), SW44.1 (A)
/COL8: J1.9, SW3.1 (A), SW13.1 (A), SW23.1 (A), SW33.1 (A), SW43.1 (A)
/COL9: J1.10, SW2.1 (A), SW12.1 (A), SW22.1 (A), SW32.1 (A), SW42.1 (A)
/COL10: J1.11, SW1.1 (A), SW11.1 (A), SW21.1 (A), SW31.1 (A), SW41.1 (A)
/ROW1: D1.1 (K), D2.1 (K), D3.1 (K), D4.1 (K), D5.1 (K), D6.1 (K), D7.1 (K), D8.1 (K), D9.1 (K), D10.1 (K), J1.12
/ROW2: D11.1 (K), D12.1 (K), D13.1 (K), D14.1 (K), D15.1 (K), D16.1 (K), D17.1 (K), D18.1 (K), D19.1 (K), D20.1 (K), J1.13
/ROW3: D21.1 (K), D22.1 (K), D23.1 (K), D24.1 (K), D25.1 (K), D26.1 (K), D27.1 (K), D28.1 (K), D29.1 (K), D30.1 (K), J1.14
/ROW4: D31.1 (K), D32.1 (K), D33.1 (K), D34.1 (K), D35.1 (K), D36.1 (K), D37.1 (K), D38.1 (K), D39.1 (K), D40.1 (K), J1.15
/ROW5: D41.1 (K), D42.1 (K), D43.1 (K), D44.1 (K), D45.1 (K), D46.1 (K), D47.1 (K), D48.1 (K), D49.1 (K), J1.16
GND: H3.1, H4.1, J1.MP (MountPin)
unnamed: D1.2 (A), SW1.2 (B)
unnamed: D2.2 (A), SW2.2 (B)
unnamed: D3.2 (A), SW3.2 (B)
unnamed: D4.2 (A), SW4.2 (B)
unnamed: D5.2 (A), SW5.2 (B)
unnamed: D6.2 (A), SW6.2 (B)
unnamed: D7.2 (A), SW7.2 (B)
unnamed: D8.2 (A), SW8.2 (B)
unnamed: D9.2 (A), SW9.2 (B)
unnamed: D10.2 (A), SW10.2 (B)
unnamed: D11.2 (A), SW11.2 (B)
unnamed: D12.2 (A), SW12.2 (B)
unnamed: D13.2 (A), SW13.2 (B)
unnamed: D14.2 (A), SW14.2 (B)
unnamed: D15.2 (A), SW15.2 (B)
unnamed: D16.2 (A), SW16.2 (B)
unnamed: D17.2 (A), SW17.2 (B)
unnamed: D18.2 (A), SW18.2 (B)
unnamed: D19.2 (A), SW19.2 (B)
unnamed: D20.2 (A), SW20.2 (B)
unnamed: D21.2 (A), SW21.2 (B)
unnamed: D22.2 (A), SW22.2 (B)
unnamed: D23.2 (A), SW23.2 (B)
unnamed: D24.2 (A), SW24.2 (B)
unnamed: D25.2 (A), SW25.2 (B)
unnamed: D26.2 (A), SW26.2 (B)
unnamed: D27.2 (A), SW27.2 (B)
unnamed: D28.2 (A), SW28.2 (B)
unnamed: D29.2 (A), SW29.2 (B)
unnamed: D30.2 (A), SW30.2 (B)
unnamed: D31.2 (A), SW31.2 (B)
unnamed: D32.2 (A), SW32.2 (B)
unnamed: D33.2 (A), SW33.2 (B)
unnamed: D34.2 (A), SW34.2 (B)
unnamed: D35.2 (A), SW35.2 (B)
unnamed: D36.2 (A), SW36.2 (B)
unnamed: D37.2 (A), SW37.2 (B)
unnamed: D38.2 (A), SW38.2 (B)
unnamed: D39.2 (A), SW39.2 (B)
unnamed: D40.2 (A), SW40.2 (B)
unnamed: D41.2 (A), SW41.2 (B)
unnamed: D42.2 (A), SW42.2 (B)
unnamed: D43.2 (A), SW43.2 (B)
unnamed: D44.2 (A), SW44.2 (B)
unnamed: D45.2 (A), SW45.2 (B)
unnamed: D46.2 (A), SW46.2 (B)
unnamed: D47.2 (A), SW47.2 (B)
unnamed: D48.2 (A), SW48.2 (B)
unnamed: D49.2 (A), SW49.2 (B)

Notes on the sheet:
diodes: BAS70X-TP keys: TL3315NF100Q

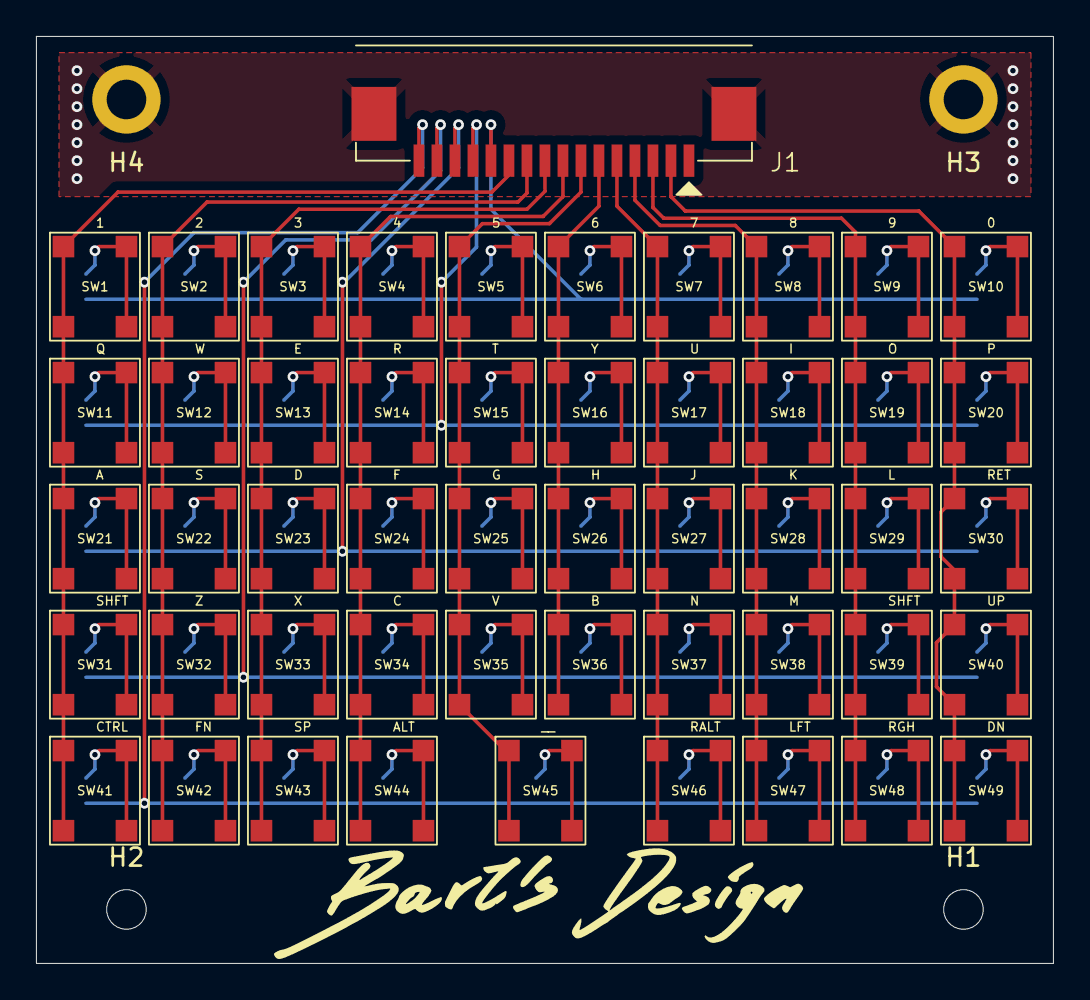
[picture p32: board airMouse-keyboard.kicad_pcb from above]

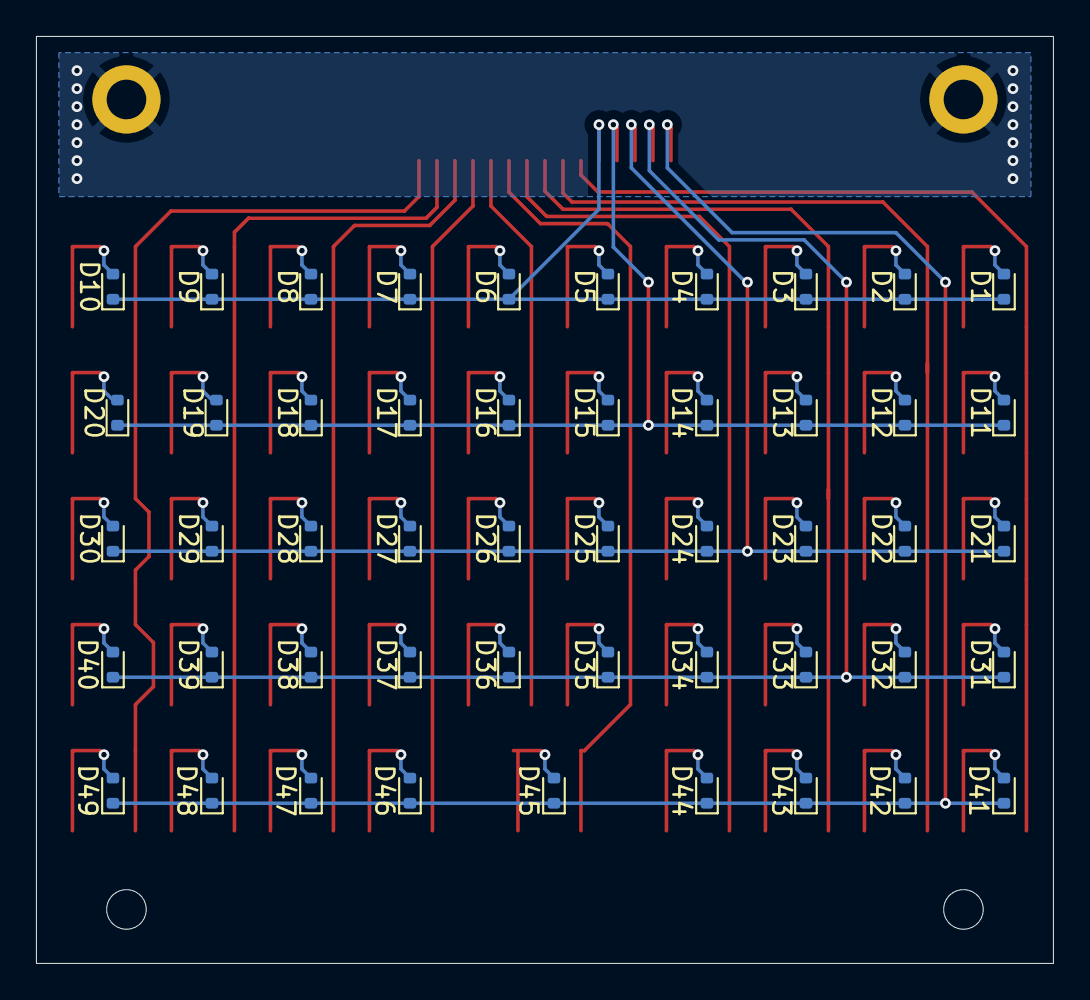
[picture p33: board airMouse-keyboard.kicad_pcb from below]

Board: 2 copper layers, 56.5 x 51.5 mm, 104 parts (49 on the bottom side), 65 nets.
