bartoszp1992/airMouse/airMouse-firmware/airMouse-firmware.ioc

Mcu.UserName=STM32G071RBTx
PA0.GPIO_Label=GYRO_INT
PA0.Signal=GPXTI0
PA1.GPIO_Label=LED_BLUE
PA1.Signal=GPIO_Output
PA10.Signal=I2C1_SDA
PA4.GPIO_Label=LED_RED
PA4.Signal=GPIO_Output
PA5.GPIO_Label=LED_GREEN
PA5.Signal=GPIO_Output
PA9.Signal=I2C1_SCL
PB0.GPIO_Label=BAT+
PB0.Signal=ADC1_IN8
PB1.GPIO_Label=KBD_COL1
PB1.Signal=GPIO_Input
PB10.GPIO_Label=KBD_COL10
PB10.Signal=GPIO_Input
PB14.GPIO_Label=ESP_BOOT
PB14.Signal=GPIO_Output
PB15.GPIO_Label=ESP_EN
PB15.Signal=GPIO_Output
PB2.GPIO_Label=KBD_COL2
PB2.Signal=GPIO_Input
PB3.GPIO_Label=KBD_COL3
PB3.Signal=GPIO_Input
PB4.GPIO_Label=KBD_COL4
PB4.Signal=GPIO_Input
PB5.GPIO_Label=KBD_COL5
PB5.Signal=GPIO_Input
PB6.GPIO_Label=KBD_COL6
PB6.Signal=GPIO_Input
PB7.GPIO_Label=KBD_COL7
PB7.Signal=GPIO_Input
PB8.GPIO_Label=KBD_COL8
PB8.Signal=GPIO_Input
PB9.GPIO_Label=KBD_COL9
PB9.Signal=GPIO_Input
PC10.GPIO_Label=MUS_DN
PC10.Signal=GPIO_Input
PC11.GPIO_Label=MUS_PRC
PC11.Signal=GPIO_Input
PC12.GPIO_Label=MUS_HOME
PC12.Signal=GPIO_Input
PC13.GPIO_Label=MUS_DPI
PC13.Signal=GPIO_Input
PC4.GPIO_Label=ESP_TX
PC4.Signal=USART1_TX
PC5.GPIO_Label=ESP_RX
PC5.Signal=USART1_RX
PC6.GPIO_Label=MUS_LB
PC6.Signal=GPXTI6
PC7.GPIO_Label=MUS_MB
PC7.Signal=GPIO_Input
PC8.GPIO_Label=MUS_RB
PC8.Signal=GPIO_Input
PC9.GPIO_Label=MUS_UP
PC9.Signal=GPIO_Input
PD1.GPIO_Label=KBD_ROW1
PD1.Signal=GPIO_Output
PD2.GPIO_Label=KBD_ROW2
PD2.Signal=GPIO_Output
PD3.GPIO_Label=KBD_ROW3
PD3.Signal=GPIO_Output
PD4.GPIO_Label=KBD_ROW4
PD4.Signal=GPIO_Output
PD5.GPIO_Label=KBD_ROW5
PD5.Signal=GPIO_Output
