bartoszp1992/airMouse/(commit log)

2025-02-04 working mouse move
    [mfg_nvs.csv]
2025-02-05 add gyro library
2025-02-06 completed IMU library base
2025-02-08 faster ESP UART
2025-02-08 i2c variant
2025-02-08 working fast acceleration
    [cursorPositionCounting.ods]
2025-02-11 slow acceleration
    [accelerationFormula.ods, airMouse-pcb.kicad_pcb, airMouse-pcb.kicad_sch, cursorPositionCounting.ods, mfg_nvs.csv]
2025-02-11 initial schematic
    [airMouse-pcb.kicad_sch, keyboard.kicad_sch]
2025-02-11 key footprint
    [airMouse-pcb.kicad_pcb, keyboard.kicad_sch]
2025-02-12 add keyboard
    [TL3315NF100Q.FCStd, TL3315NF100Q.step, TL3315NF100Q.stl, airMouse-pcb.kicad_pcb, airMouse-pcb.kicad_sch, keyboard.kicad_sch, mouse.kicad_sch]
2025-02-13 add adc channel
    [airMouse-pcb.kicad_sch]
2025-02-13 page data
    [airMouse-pcb.kicad_sch, keyboard.kicad_sch, mouse.kicad_sch]
2025-02-15 output for keyboard
    [airMouse-keyboard-B_Cu.gbr, airMouse-keyboard-B_Mask.gbr, airMouse-keyboard-B_Paste.gbr, airMouse-keyboard-B_Silkscreen.gbr, airMouse-keyboard-Edge_Cuts.gbr, airMouse-keyboard-F_Cu.gbr, airMouse-keyboard-F_Mask.gbr, airMouse-keyboard-F_Paste.gbr]
2025-02-15 add mouse pcb
    [airMouse-mcu.kicad_pcb, airMouse-mcu.kicad_sch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]
2025-02-15 thumb pcb
    [airMouse-mcu.kicad_pcb, airMouse-mcu.kicad_sch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]
2025-02-15 components placed on mcu board
    [airMouse-mcu.kicad_pcb, airMouse-mcu.kicad_sch, keyboard.kicad_sch, mouse.kicad_sch]
2025-02-15 add mcu board
    [airMouse-mcu-B_Cu.gbr, airMouse-mcu-B_Mask.gbr, airMouse-mcu-B_Paste.gbr, airMouse-mcu-B_Silkscreen.gbr, airMouse-mcu-Edge_Cuts.gbr, airMouse-mcu-F_Cu.gbr, airMouse-mcu-F_Mask.gbr, airMouse-mcu-F_Paste.gbr]
2025-02-17 updated mcu board BOM with external components
    [airMouse-mcu.csv, airMouse-thumb.csv]
2025-02-17 initializing housing
    [RC1_assembly.FCStd, RC1_main.FCStd, airMouse-keyboard.step, airMouse-mcu.csv, airMouse-mcu.kicad_sch, airMouse-mcu.step, airMouse-mouse.step, airMouse-thumb.step]
2025-02-17 adds keyboard
    [RC1_assembly.FCStd, RC1_main.FCStd]
2025-02-18 add assembly
    [RC1_assembly.FCStd, RC1_main.FCStd]
2025-02-19 1mm thickness boards
    [RC1_assembly.FCStd, RC1_main.FCStd, airMouse-keyboard.kicad_pcb, airMouse-keyboard.step, airMouse-mcu.kicad_pcb, airMouse-mcu.step, airMouse-mouse.kicad_pcb, airMouse-mouse.step]
2025-02-19 updated housing
    [RC1_assembly.FCStd, RC1_main.FCStd, airMouse-mcu.kicad_pcb]
2025-02-19 placed mouse and thumb
    [RC1_assembly.FCStd]
2025-02-19 add ufl key
    [RC1_assembly.FCStd, RC1_main.FCStd, u.fl_key-Body.stl, u.fl_key.FCStd]
2025-02-19 add coil to mcu pcb
    [RC1_assembly.FCStd, RC1_main.FCStd, airMouse-mcu.kicad_pcb, airMouse-mcu.step]
2025-02-20 add connectors 3d models
    [RC1_assembly.FCStd, RC1_main.FCStd, airMouse-keyboard.kicad_pcb, airMouse-keyboard.step, airMouse-mcu.kicad_pcb, airMouse-mcu.kicad_sch, airMouse-mcu.step, airMouse-mouse.kicad_pcb]
2025-02-20 pending housing
    [RC1_main-housing.step, RC1_main-housing.stl, RC1_main-mouse distance.step, RC1_main-mouse distance.stl, RC1_main.FCStd]
2025-02-21 better pcb models
    [airMouse-thumb.step]
2025-02-21 new housing concept
    [airMouse-keyboard.kicad_pcb, airMouse-thumb.step]
2025-02-21 housing pending...
    [airMouse-mcu.kicad_pcb]
2025-02-22 housing work pending
    [RC1_main-bottom base.stl, RC1_main-top base.stl]
2025-02-22 add button
    [RC1_main-bottom base.stl, RC1_main-housing.step, RC1_main-housing.stl, RC1_main-mouse distance.step, RC1_main-mouse distance.stl, RC1_main-top base.stl, airMouse-mouse.stl, airMouse-thumb.stl]
2025-02-27 add todo
    [RC1_main-bottom base.stl, RC1_main-keyboard array.stl, RC1_main-laser key.stl, RC1_main-top base.stl, RC1_main-top cover.stl, airMouse-mcu.kicad_sch]
2025-02-27 fixed home/prc and fwd/bck
    [airMouse-mcu.kicad_sch, mouse.kicad_sch]
2025-02-27 updated for kicad 9
    [airMouse-keyboard.kicad_pcb, airMouse-keyboard.kicad_sch, airMouse-mcu.kicad_pcb, airMouse-mcu.kicad_sch, airMouse-thumb.kicad_pcb, airMouse-thumb.kicad_sch]
2025-02-28 dont know, why voltage drops
    [RC1_main-integrating pin.stl, airMouse-mcu.kicad_pcb, airMouse-mcu.kicad_sch]
2025-02-28 works with android
    [airMouse-mcu.kicad_pcb, airMouse-mcu.kicad_sch]
2025-03-03 created startBoost simulation
    [airMouse-mcu.kicad_sch]
2025-03-04 fixed receiving data- overrun turned off
    [airMouse-mcu.kicad_pcb, airMouse-mcu.kicad_sch]
2025-03-05 parsing OK, ERROR and ready responses working!
    [airmouse.c]
2025-03-05 added not-working DMA functions to ESPAT
2025-03-08 returning esp32 response status
2025-03-08 working on mouse buttons
2025-03-08 diagnosed continously pressed mouse button. If button are released, report isn't sent- becouse there's no action. So, in last report computer see that button are pressed
2025-03-11 fixed housing
    [RC1_main-bottom base.stl, RC1_main-bottom cover.stl, RC1_main-integrating pin.stl, RC1_main-top base.stl, RC1_main-top cover.stl]
2025-03-11 fixed bottom base and bottom cover
    [RC1_main-bottom base.stl, RC1_main-bottom cover.stl]
2025-03-12 improved keyboard library
    [airMouse-mcu.kicad_sch]
2025-03-15 included esp-at firmware sources, and binaries fixed polling rate on linux
    [airMouse-mcu.kicad_sch, mfg_nvs.csv]
2025-03-15 testing low power modes
    [airMouse-mcu.kicad_sch]
2025-03-15 low power
2025-03-17 working on
    [airMouse-mcu.kicad_sch, mfg_nvs.csv]
2025-03-20 new mcu pcb
    [airMouse-mcu.kicad_pcb, airMouse-mcu.kicad_sch, keyboard.kicad_sch, mouse.kicad_sch]
2025-03-21 new mcu-pcb
    [airMouse-mcu-B_Cu.gbr, airMouse-mcu-B_Mask.gbr, airMouse-mcu-B_Paste.gbr, airMouse-mcu-B_Silkscreen.gbr, airMouse-mcu-Edge_Cuts.gbr, airMouse-mcu-F_Cu.gbr, airMouse-mcu-F_Mask.gbr, airMouse-mcu-F_Paste.gbr]
2025-03-22 working connect and disconnect
    [airMouse-mcu.kicad_pcb]
2025-03-22 add ble hid table
    [BLE HID services.ods]
2025-03-24 add gatts table
    [gatts_data.csv]
2025-03-31 new mcu board tests
    [BLE HID services.ods]
2025-03-31 mini2 frame
    [RC1_assembly.FCStd, RC1_main-bottom base.stl, RC1_main-bottom cover.stl, RC1_main-integrating pin.stl, RC1_main-keyboard array.stl, RC1_main-laser key.stl, RC1_main-top base.stl, RC1_main-top cover.stl]
2025-04-01 working on mini2
    [airMouse-mouse.kicad_pcb, mini2-button large.stl, mini2-button middle.stl, mini2-button small.stl, mini2-lid.stl, mini2-main.stl, mini2-scroll.stl]
2025-04-01 new main of mini2
    [mini2-main.stl]
2025-04-02 larger buttons
    [mini2-button large.stl, mini2-button middle.stl, mini2-button small.stl, mini2-lid.stl, mini2-scroll.stl]
2025-04-11 new mini2
    [mini2-main.stl, mini2-scroll.stl]
