bartoszp1992/airMouse/(notices)

Notices in the files:
airMouse-firmware/Inc/main.h:
Copyright (c) 2025 STMicroelectronics.
All rights reserved.
This software is licensed under terms that can be found in the LICENSE file
